IoT-Systems-Lab/Smart-Bike/Gateway/Gateway/IAQ.png

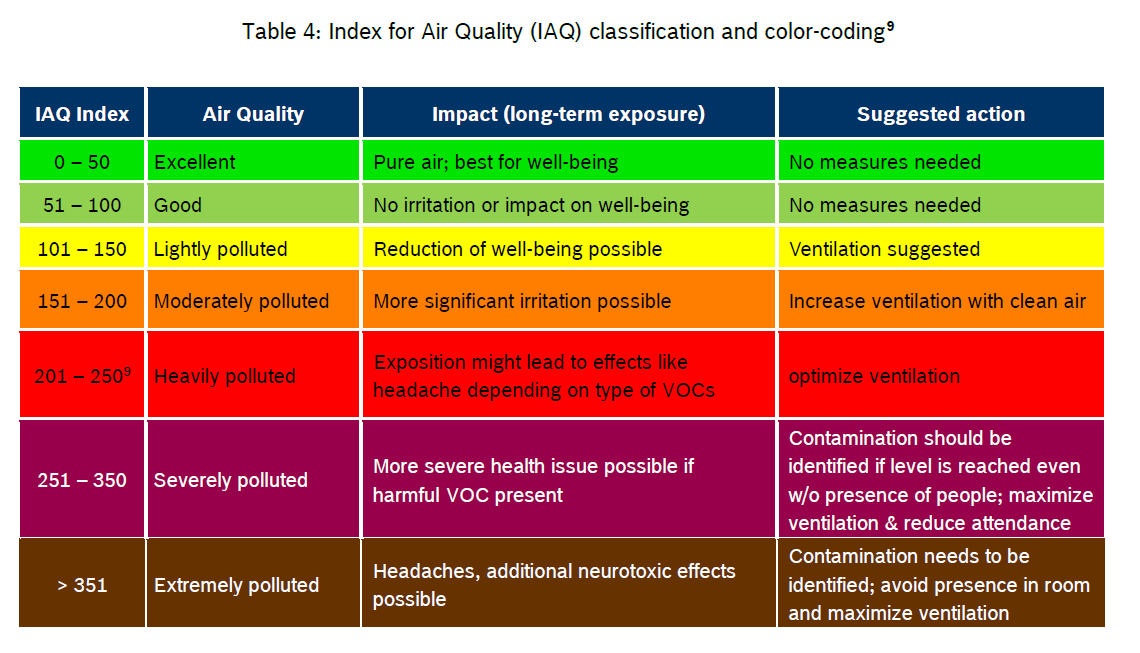
Gateway/Gateway/IAQ.png
