IoT-Systems-Lab/Smart-Bike/BOM/BOM_Mouser.xlsx

Sheet: aanvraag
AANVRAAG TOT BESTELLING < 8.500€ excl BTW
KREDIETINFO |  | BESTEL/LEVERINGSINFO
krediettype* |  | naam aanvrager |  |  | Geef dit door aan het antennelid
 |  | U-nr aanvrager |  |  | enof meldt dit hier reeds bondig.
kredietnummer |  | bestelling door? |  |  | bv specifieke leverinfo
BEDRIJFSINFO |  | bestelemail van het bedrijf
bedrijfsnaam | Mouser | VGM : O**
BTW-nr |  | WERKWIJZE ARTIKELS
straat + nr |  | Op het tweede tabblad staat een hele reeks kostensoorten. Diegene die niet van toepassing zijn op de KULLOC Gent zijn
postcode + plaats |  | reeds verwijderd. Via kolom B kan u de hele reeks filteren. Deze filter kunt u nog verfijnen via de filter in kolom C.
buitenland |  | Finaal kopieert u de juiste rubriek uit kolom A en plakt u deze in onderstaande rubriekkolom.
ARTIKELGEGEVENS |  |  |  |  |  | excl BTW
rubriek | gedetailleerde omschrijving [voor chemicaliën(gevaarlijk of schadelijk) : art.nr + CAS nr] |  |  |  | aantal | p/e | subtotaal
50654 | ESP32-C3 microcontroller [356-ESP32C3WROM02UN4] |  |  |  | 3 | 3.42 | 10.26
50654 | Ambient Light Sensors LOW PWR,HI SENS AMBIENT SENSOR [VEML6035] |  |  |  | 1 | 1.01 | 1.01
50654 | 2.4GHz omnidirectionele antenne [909-ENNAWIFIBTUFL] |  |  |  | 2 | 0.98 | 1.96
50654 | MOSFETs Transistor, MOSFET Nch, 20V(Vdss), 3.0A(Id), (2.5V Drive) [0755-RA1C030LDT5CL] |  |  |  | 3 | 0.42 | 1.26
50654 | BOSCH BME680 sensor [262-BME680] |  |  |  | 1 | 7.44 | 7.44
50654 | GNSS/GPS Modules Teseo ROM GNSS module [TESEO-LIV3R] |  |  |  | 1 | 9.58 | 9.58
50654 | Bluetooth Modules - 802.15.1 BGM260P Module 2.4G Built in Antenna Vault High 20dBm 3200kB 512kB(RAM) 26GPIO [634-BGM260PB32VNA2] |  |  |  | 1 | 9.66 | 9.66
50654 | IMUs - Inertial Measurement Units World's Lowest Power 9-Axis MEMS MotionTracking Device [ICM-20948] |  |  |  | 2 | 5.83 | 11.66
50654 | Board Mount Hall Effect/Magnetic Sensors 3-wire uPower Unipolar Direct South Switch Ts=100ms PP Bop/Brp 3.6/2.1mT [MLX92216ELQ-AAC-001-RE] |  |  |  | 5 | 0.34 | 1.72
50654 | USB-C connector [640-USB4215-03-A] |  |  |  | 5 | 0.52 | 2.60
50654 | Mini button [640-SWT0010015016SSA] |  |  |  | 10 | 0.45 | 4.45
50654 | Headers & Wire Housings PHD HEADER (SIDE) [S10B-PHDSS(LF)(SN)(P)] |  |  |  | 2 | 0.33 | 0.65
50654 | Power Switch ICs - Power Distribution 0.73-? 5-V ultra-l ow leakage load switch [TPS22860DBVR] |  |  |  | 1 | 0.89 | 0.89
50654 | Power Switch ICs - Power Distribution Low Input Voltage Du al Load Switch [TPS22960DCNR] |  |  |  | 1 | 0.77 | 0.77
50654 | Antennas Embedded Antenna, FPC + Cable, Adhesive mount, 39.45 13.25mm, Passive, GNSS L1*1,100mm, RF1.13, RF1, RoHS&REACH Compliant [YFGA003AA] |  |  |  | 1 | 1.64 | 1.64
50654 | Schottky Diodes & Rectifiers Diode Schottky 25V 1A 2-Pin [RB161MM-20TR] |  |  |  | 10 | 0.26 | 2.55
50654 | Signal Conditioning - 40 C to + 85 C 1.5824 GHz 1 dB 2 MHz, 4.092 MHz, 8.34 MHz 50 Ohms GNSS [B39162B4327P810] |  |  |  | 1 | 1.28 | 1.28
50654 | LDO Voltage Regulators AC 200mA Low IQ LDO Reg [TLV70018QDDCRQ1] |  |  |  | 1 | 0.78 | 0.78
50654 | Power Switch ICs - Power Distribution 5.5-V 2-A 80-mohm 10-nA leakage load A 595-TPS22917DBVT [TPS22917DBVR] |  |  |  | 1 | 0.40 | 0.40
50654 | RF Amplifier RF SILICON MMIC [BGA725L6E6327FTSA1] |  |  |  | 5 | 0.32 | 1.59
50654 | RF Connectors / Coaxial Connectors SMT MALE RECEPT AU [U.FL-R-SMT-1(60)] |  |  |  | 1 | 0.97 | 0.97
50654 | Headers & Wire Housings 20P SINGLE ROW [2-826646-0] |  |  |  | 1 | 1.89 | 1.89
50654 | Headers & Wire Housings 2.54mm DRSW Hdr TH /OCap .38AuLF 2Ckt [87914-0204] |  |  |  | 1 | 0.16 | 0.16
50654 | Non-Isolated DC/DC Converters 3-17Vin 3.3Vout 1A [RPM3.3-1.0-CT] |  |  |  | 1 | 5.24 | 5.24
50654 | Translation - Voltage Levels 2B Bidir Vltg-Level Translator A 595-TXB0102DCUT [TXB0102DCUR] |  |  |  | 1 | 0.58 | 0.58
50654 | Translation - Voltage Levels 8B Bidir Vltg-Level Translator [TXB0108DQSR] |  |  |  | 1 | 1.31 | 1.31
50654 | Single Colour LEDs WL-SMTW 1608 Wtrclr TopVw Blue 3.1V 100mA 470nm |  |  |  | 2 | 0.19 | 0.38
50654 | Single Colour LEDs WL-SMTW 1608 Wtrclr TopVw Green 3.3V 100mA 515nm |  |  |  | 2 | 0.19 | 0.38
50654 | Ferrite Beads 600 OHM 1A 2 PADS [MFBA2V1608-601-R] |  |  |  | 10 | 0.04 | 0.37
50654 |  |  |  |  |  |  | 0.00
50654 |  |  |  |  |  |  | 0.00
50654 |  |  |  |  |  |  | 0.00
50654 |  |  |  |  |  |  | 0.00
50654 |  |  |  |  |  |  | 0.00
50654 |  |  |  |  |  |  | 0.00
50654 |  |  |  |  |  |  | 0.00
50654 |  |  |  |  |  |  | 0.00
50654 |  |  |  |  |  |  | 0.00
50654 |  |  |  |  |  |  | 0.00
 |  |  |  |  |  |  | 0.00
 |  |  |  |  |  |  | 0.00
Voeg gerust lijnen toe, maar zorg ervoor dat de som blijft kloppen. |  |  |  |  | 77 |  | €83.43
BEZORG MIJ VIA MAIL AAN MIJN KREDIETBEHEERDER MET ALS ONDERWERP : [ BB ] |  |  | BTW recuperatie?
* meerdere kredieten kunnen gecombineerd worden, maar geen KULC (ZKC../V…) met LRD (ZLK…) kredieten combineren |  |  | KUL C : | neen | Uw budget zal verminderen
** O kolom moet enkel aangekruist worden voor schadelijke en/of gevaarlijke producten (de meeste chemische producten). |  |  | met het bedrag incl BTW of mbt deze bestelbon : |  |  |  | €100.95
Hiervoor moet om VGM redenen ook goederenontvangst gedaan worden. Wanneer dergelijke goederen geleverd worden, |  |  | LRD : | ja | Het BTW-bedrag gaat niet van uw budget.
moet dit direct aan de financiële antenne gemeld worden (ev. levernota's bezorgen). |  |  | Dank u wel om mij volledig in te vullen

Sheet: kostensoort
 | FILTERS
Rubriek | Thema | Goed/dienst | Artikelomschrijving | Grootboekrek. | Grootboekrekeningomschrijving | Gebruik | Voorbeelden | Advies aankoopbeleid
50493 | klein onderhoud | informatica | Kl.onderhoud&herstel - hardware/netwerk | 61101010 | KLEIN ONDERH.&HERSTELL. - UITRUSTING | nazicht keuring reparaties
50492 | klein onderhoud | mach/appar & uitr | Kl.onderhoud&herstel - mach/appar & uitr | 61101010 | KLEIN ONDERH.&HERSTELL. - UITRUSTING | nazicht keuring reparaties | *) herstelling *) onderhoud & keuring toestellen *) ijken & kalibreren van apparatuur labo of elders
50495 | klein onderhoud | meubilair | Kl.onderhoud&herstel - meubilair | 61111010 | KLEIN ONDERH.&HERST - MEUBILAIR | nazicht keuring reparaties | *) reparaties meubelen *) behandeling meubilair met beschermend product
50498 | klein onderhoud | rollend materieel | Kl.onderhoud&herstel - rollend materieel | 61131010 | KLEIN ONDERH. & HERSTELL. - ROLLEND MATERIEEL | nazicht keuring reparaties | *) technische keuring voertuigen *) herstelling & onderhoud voertuigen
50501 | klein onderhoud | kunst | Kl.onderhoud&herstel - kunstwerken | 61151010 | KLEIN ONDERH. & HERSTELL. - KUNSTWERKEN | nazicht keuring reparaties | *) restauratie
50503 | klein onderhoud | boeken | Kl.onderhoud&herstel - bibliotheekboeken | 61161010 | KLEIN ONDERH. & HERSTELL. - BOEKEN BIBLIOTHEKEN |  | *) inbinden *) restauratie
50844 | huur & leasing | mach/appar & uitr | Huur & leasing machines met ak.optie | 60633000 | LEASING UITRUSTING | Voor alle machines, toestellen, apparaten, uitrusting,… | *) wetenschappelijke apparatuur *) podium *) attracties personeelsfeest | leasing met aankoopoptie verloopt via aankoop
50845 | huur & leasing | meubilair | Huur & leasing meubilair met Ak.optie | 60634000 | LEASING MEUBILAIR & ROLLEND MATERIEEL
50486 | huur & leasing | gebouwen | Huur & leasing terreinen & gebouwen | 61000010 | HUUR TERREINEN EN GEBOUWEN |  | * ) gronden, parkings, lokalen, appartement,… *) huur gîte voor teambuilding *) huurgelden kamer/studio/appt betaald door K.U.Leuven voor studenten, gastprofessoren,…
50491 | huur & leasing | mach/appar & uitr | Huur & leasing machines zonder ak.optie | 61100010 | HUUR UITRUSTING | Voor alle machines, toestellen, apparaten, uitrusting,… | *) huur kopieermachine & alle bijkomende kosten ° onderhoud ° vergoeding extra kopieën ° installatiekosten *) wetenschappelijke apparatuur *) podium *) kostuums (bvb Sinterklaas/kerstfeest) *) attracties personeelsfeest *) huur sportmateriaal *) huur EHBO hulppost bij activiteiten *) staangeld gasflessen *) huur gastank
50494 | huur & leasing | meubilair | Huur & leasing meubilair zonder Ak.optie | 61110010 | HUUR MEUBILAIR
50496 | huur & leasing | rollend materieel | Huur & leasing bedrijfswagens | 61120010 | HUUR ROLLEND MATERIEEL - BEDRIJFSWAGENS |  |  | enkel occasionele huur (bepaalde periode) anders via aankoop
50497 | huur & leasing | andere | Huur & leasing andere dan bedrijfswagens | 61130010 | HUUR ROLLEND MATERIEEL - ANDERE DAN BEDRIJFSWAGENS |  | *) huur bestelwagen *) huur aanhangwagen | enkel occasionele huur (bepaalde periode) anders via aankoop
50499 | huur & leasing | informatica | Huur databanken | 61140010 | HUUR INFORMATICA: SOFTWARE & LICENTIES |  | *) huur van gegevens op CD-ROM *) toegang tot gegevens op internet
50680 | huur & leasing | informatica | Huur informatica, software & licenties | 61140010 | HUUR INFORMATICA: SOFTWARE & LICENTIES |  | enkel bij periodiek hernieuwbare software, jaarlijkse huur webruimte, gebruik van paketten, versies => aankoop software via art 50658 of 50687
50500 | huur & leasing | kunst | Huur kunstwerken | 61150010 | HUUR KUNSTWERKEN
50502 | huur & leasing | boeken | Huur boeken | 61160010 | HUUR BOEKEN BIBLIOTHEKEN
50684 | goed | informatica | Computer-hardware < 250 EUR/st excl BTW | 61170010 | KLEINE UITRUSTING |  | *) externe harddisk | basisassortiment verkrijgbaar via PC shop
50657 | investering | informatica | Computer-hardware > 250 EUR/st excl BTW | 60610000 | UITRUSTING | Uitzonderlijk te gebruiken want basisassortiment verkrijgbaar via PC shop (printer, desktop, notebook, beeldscherm,…) | *) grote server *) grote computersystemen & -projecten | advies vragen aan PC-shop
50687 | goed | informatica | Computer-software < 250 EUR/st excl BTW | 61170010 | KLEINE UITRUSTING |  |  | basisassortiment verkrijgbaar via PC shop
50658 | investering | informatica | Computer-software > 250 EUR/st excl BTW | 60630000 | SOFTWARE | Uitzonderlijk te gebruiken want basisassortiment verkrijgbaar via PC shop | *) specifieke softwaretoepassingen | advies vragen aan PC-shop of aankoop
50507 | goed | meubilair | Inrichting < 250 EUR/st excl BTW | 61170010 | KLEINE UITRUSTING |  | *) gordijnen *) spiegel *) signalisatiebordjes
50839 | investering | meubilair | Inrichting > 250 EUR/st excl BTW | 60620000 | MEUBILAIR
50506 | uitzonderlijk | meubilair | Meubilair < 250 EUR/st excl BTW | 61170010 | KLEINE UITRUSTING |  | *) kapstok
50836 | uitzonderlijk | meubilair | Meubilair > 250 EUR/st excl BTW | 60620000 | MEUBILAIR |  | *) zetel voor wachtruimte *) ergonomisch/aangepast meubilair *) borden, tafels, stoelen, kasten | raamcontract gebruiken voor standaard meubilair - bij afwijkingen advies aan aankoop vragen
50505 | goed | meubilair | Uitrusting&machines < 250EUR/st excl btw | 61170010 | KLEINE UITRUSTING | Voor alle machines, toestellen, apparaten, uitrusting,… | *) bureaulamp *) koffiezet *) tafelwagen voor labo
50510 | uitzonderlijk | andere | Communicatie - Toestellen | 61170010 | KLEINE UITRUSTING |  | *) dictafoon *) antwoordapparaat *) webcam | *) voor GSM's contacteer aankoop *) voor faxtoestellen: raamcontract *) voor vaste telefoontoestellen : contacteer centrale dispatch
50814 | goed | mach/appar & uitr | Uitrusting&machines > 250EUR/st excl BTW | 60610000 | UITRUSTING | Voor alle machines, toestellen, apparaten, uitrusting,… | *) microscoop *) LCD projector *) TV toestel *) brandblusser *) brander *) autoclaaf *) waterpompen
50488 | uitzonderlijk | andere | Bewaking door derden | 61004000 | BEWAKING DOOR DERDEN |  |  | raamcontract TD - contacteer de dienst beveiliging & schoonmaakbeleid
50489 | uitzonderlijk | andere | Schoonmaak door derden | 61005000 | SCHOONMAAK DOOR DERDEN |  |  | raamcontract TD - contacteer de dienst beveiliging & schoonmaakbeleid
50490 | uitzonderlijk | andere | Verhuiskosten | 61006000 | VERHUISKOSTEN | Voor alle kosten m.b.t. verhuizing (huur dozen, werkuren personeel,…) |  | Bij voorkeur per e-mail aanvragen bij de centrale dispatch
50512 | dienst | labo | Leveringen - gas | 61201002 | LEVERINGEN - GAS |  |  | raamcontract TD
50517 | uitzonderlijk | andere | Linnen & kledij: aankoop | 61201006 | LEVERINGEN - LINNEN & KLEDIJ: AANKOOP & ONDERHOUD |  | *) vlag *) sportkledij *) badmutsen *) handschoenen labo *) stoffen rollen / handdoeken | Voor de meeste werkkledij bestaat er een raamcontract: contacteer de dienst schoonmaakbeleid
50516 | klein onderhoud | andere | Linnen & kledij: onderhoud & herstelling | 61201006 | LEVERINGEN - LINNEN & KLEDIJ: AANKOOP & ONDERHOUD
50518 | uitzonderlijk | andere | Persoonlijke beschermingsmiddelen | 61201006 | LEVERINGEN - LINNEN & KLEDIJ: AANKOOP & ONDERHOUD | uitsluitend voor specifieke persoonlijke beschermingsmiddelen | *) laserbrillen *) glasblazerbrillen *) bescherming kettingzagen | aanvraagformulier PBM voor standaard persoonlijke beschermingsmiddelen (veiligheidsbrillen, maskers, hittebestendige handschoenen, gehoorbescherming, veiligheidsschoenen, …)
50654 | goed | labo | Materiaal atelier / werkplaats | 61201008 | LEVERINGEN - ONDERZOEKSMATERIAAL & PRODUCTEN LABO |  | * )metalen *) hout *) schroeven *) handgereedschap *) elektr. componenten/gereedsch./materiaal | heel veel items zijn voorradig in de magazijnen
50520 | goed | labo | Materiaal labo - géén uitrust of product | 61201008 | LEVERINGEN - ONDERZOEKSMATERIAAL & PRODUCTEN LABO |  | *) naalden *) glaswerk *) disposables *) elektronische, mechanische en elektrische componenten buiten CDE *) staangeld gasflessen
50652 | goed | labo | Laboproducten (zonder R-zin of vergunn) | 61201008 | LEVERINGEN - ONDERZOEKSMATERIAAL & PRODUCTEN LABO | uitsluitend voor niet gevaarlijke producten | *) gedistilleerd water *) stikstof *) micro-organismen *) biochemische producten zonder R-zin of vergunning | rechtstreeks in SAP of via CASP - producten met gevaren-zin of externe vergunning moeten in SAP besteld worden via tabblad "chemische materialen"
42457 | uitzonderlijk | andere | Leveringen - liturgie | 61201009 | LEVERINGEN - LITURGIE
46497 | uitzonderlijk | informatica | Levering informaticadiensten | 61201010 | LEVERING INFORMATICADIENSTEN |  | *) software upgrade *) onderhoud *) technische bijstand *) creatie website *) …
50870 | uitzonderlijk | werking | Kosten m.b.t. landbouwproducten | 61210001 | KOSTEN M.B.T. LANDBOUWPRODUCTEN
50664 | uitzonderlijk | derden | Prijzengeld betaald aan derden | 61300300 | PRIJZENGELD BETAALD AAN DERDEN |  | *) prijs toegekend aan een student
50665 | uitzonderlijk | derden | Auteursrechten (géén SABAM of REPROBEL) | 61300400 | AUTEURSRECHTEN | Bij betaling aan een privé persoon (geen centrale instantie, zie art. 50908)
50668 | uitzonderlijk | derden | Vergoeding stagementoren | 61300800 | VERGOEDING STAGEMENTOREN
50669 | uitzonderlijk | derden | Erelonen advocaten | 61310100 | ERELONEN ADVOCATEN
50670 | uitzonderlijk | derden | Erelonen octrooi / patentbureau's | 61310200 | ERELONEN OCTROOI / PATENTBUREAU'S
50673 | uitzonderlijk | derden | Kosten analyses laboratoria | 61310300 | ERELONEN LABORATORIA |  | *) uitbesteding wetenschappelijk experiment
50675 | dienst | derden | Erelonen adviesbureau - productiefirma's - externe sprekers | 61310400 | ERELONEN ADVIESBUREAUS-PRODUCTIEFIRMAS-CONSULTANTS |  | *) aankoop van data (vb meteorologisch instituut) *) aankoop van (markt)onderzoeken, rapporten *) externe sprekers *) keuringen *) analyses *) …
50677 | dienst | derden | Erelonen Consultants & Audit | 61310400 | ERELONEN ADVIESBUREAUS-PRODUCTIEFIRMAS-CONSULTANTS |  | *) vergoeding externe docent
50676 | uitzonderlijk | derden | Kosten vertalers, gidsen, artiesten,... | 61310400 | ERELONEN ADVIESBUREAUS-PRODUCTIEFIRMAS-CONSULTANTS |  | *) rondleiding museum *) scheidsrechters | raamcontract voor vertalingen
50690 | uitzonderlijk | informatica | Computer-verbruiksartikelen < 250EUR/st | 61312000 | KANTOORBENODIGDHEDEN
50679 | uitzonderlijk | kantoor | Kantoorartikelen < 250 EUR/ST excl.BTW | 61312000 | KANTOORBENODIGDHEDEN | heel uitzonderlijk |  | meeste zaken te verkrijgen via raamcontract of de magazijnen
51016 | uitzonderlijk | andere | Onderhoud & verzorging planten in burelen | 61312000 | KANTOORBENODIGDHEDEN
50682 | dienst | werking | Opleiding - seminaries - conferenties | 61315000 | OPLEIDING - SEMINARIES - CONFERENTIES | Voor élke opleiding-seminarie-conferentie waarvan K.U.Leuven de kosten draagt | *) inschrijvingsgeld opleiding buitenlandse student *) inschrijvingsgeld studiedag
50683 | uitzonderlijk | werking | Medische kosten | 61316000 | MEDISCHE KOSTEN |  | *) geneesmiddelen voor studenten *) geneesmiddelen, windels, plakkers voor huisapotheek of EHBO kit *) facturen controle-artsen, vaccins aan personeel,…
50686 | goed | boeken | Boeken - tijdschriften - kranten | 61320000 | BOEKEN - TIJDSCHRIFTEN - KRANTEN - LIDMAATSCH.BIJDR. |  | *) DVD met daarop een naslagwerk
50688 | dienst | boeken | Lidmaatschapsbijdragen | 61320000 | BOEKEN - TIJDSCHRIFTEN - KRANTEN - LIDMAATSCH.BIJDR. |  | *) Vlerick alumni club *) CM lidmaatschap studenten
50689 | uitzonderlijk | andere | Tussenkomst personeelsverenigingen | 61321000 | TUSSENKOMST PERSONEELSVERENIGINGEN |  | *) K.U.Leuven wandelclub
50691 | uitzonderlijk | geschenk | Geschenken aan niét-personeelsleden | 61330000 | GESCHENKEN AAN NIET-PERSONEELSLEDEN |  | *) trofeeën en medailles
50713 | uitzonderlijk | geschenk | Geschenken aan personeel (vrijgesteld) | 61331000 | GESCHENKEN AAN PERSONEEL (VRIJGESTELD) |  | *) kado-bon voor stagiair die via K.U.Leuven contract was tewerkgesteld (dus géén interim of géén externe consultant) *) afscheidskado bij pensionering
50718 | uitzonderlijk | geschenk | Giften en liberaliteiten | 61332000 | GIFTEN & LIBERALITEITEN
50716 | uitzonderlijk | geschenk | Sponsering (extern) | 61333000 | SPONSORING (EXTERN) |  | *) kindervoetbalclub
50721 | uitzonderlijk | andere | Waarborgen | 61360000 | WAARBORGEN |  | *) waarborg
50724 | uitzonderlijk | andere | Communicatie - gesprekskosten | 61370000 | TELEFOON, GSM & FAX |  |  | GSM via aankoopdienst - vaste telefonie via TD
50726 | uitzonderlijk | andere | Internet & TV | 61371000 | INTERNET & TV | voor alle types internetaansluiting en tv |  | *) voor internet: contact opnemen met aankoop *) voor kabeltelevisie: contact opnemen met TD
50730 | goed | kantoor | Verzendings- & frankeerkosten post | 61372000 | VERZENDINGS- & FRANKEERKOSTEN POST |  | *) postzegels *) postpakjes | contacteer de centrale logistieke diensten
50735 | goed | drukwerk | Fotokopies | 61380000 | DRUKWERK & ADVERTENTIES |  | *) reproducties bv. foto, scan, kleurendia, microfilm… *) fotokopiekaart: kaart waar geld op staat en waar men dan fotokopieën kan nemen
50733 | dienst | drukwerk | Drukwerk - publicaties | 61380000 | DRUKWERK & ADVERTENTIES | Alle drukwerk dat we bij drukkerij kunnen aankopen | *) enveloppen met label K.U.Leuven *) naamkaartjes | contacteer de cel marketingadvies binnen de dienst communicatie voor advies ivm drukwerk, publicaties, publiciteit en advertenties (http://www.kuleuven.be/communicatie/raamcontract.html)
50739 | dienst | drukwerk | Publiciteit & advertenties | 61380000 | DRUKWERK & ADVERTENTIES |  |  | contacteer de cel marketingadvies binnen de dienst communicatie voor advies ivm drukwerk, publicaties, publiciteit en advertenties (http://www.kuleuven.be/communicatie/raamcontract.html)
50917 | dienst | catering | Catering zonder bediening | 61381000 | CATERING & RESTAURANT |  | *) cantus studenten
50745 | dienst | catering | Restaurant & catering met bediening | 61381000 | CATERING & RESTAURANT |  | *) lunch/diner in Faculty Club
50748 | goed | catering | kantinebenodigdheden personeel | 61382000 | KANTINEBENODIGDHEDEN PERSONEELSREFTER | Geen materiaal of uitrusting | *) frisdranken *) koffie *) suiker | raamcontract bij Alma
50760 | dienst | werking | Beurzen - tentoonstellingen | 61383000 | BEURZEN - TENTOONSTELLINGEN |  | *) inkomgeld tentoonstelling *) kosten mbt organisatie beurs (incl. adsl, electriciteit …)
51149 | uitzonderlijk | werking | Culturele activiteit | 61383000 | BEURZEN - TENTOONSTELLINGEN |  | *) museumbezoek *) film *) uitstap personeel *)
50767 | dienst | werking | Verblijf- & verplaatsingskosten | 61500000 | VERBLIJF- & VERPLAATSINGSKOSTEN | énkel het verblijf en de verplaatsing, niet: eten & drinken (=> catering) | *) hotel, appartement bij verplaatsing in dienstverband *) trein, taxi, bus, vliegtuig *) busreizen studenten *) kosten verblijfsvergunning
50768 | dienst | andere | Transportkosten goederen | 61520000 | TRANSPORTKOSTEN GOEDEREN |  |  | contacteer de centrale logistieke diensten
50770 | uitzonderlijk | andere | Afval transport & - verwerking | 61530000 | AFVALTRANSPORT & -VERWERKING
50772 | uitzonderlijk | andere | Interims (uitzendkrachten) | 61700000 | UITZENDKRACHTEN | enkel via erkend uitzendbureau | *) Adecco *) Randstad
51086 | uitzonderlijk | andere | Invoerrechten, douane, accijnzen | 64014000 | DOUANE & ACCIJNZEN | enkel voor invoerrechten, douane of accijnzen die vooraf gekend zijn en besteld kunnen worden
52415 | uitzonderlijk | andere | Administratieve kost | 61313500 | ADMINISTRATIEVE KOST | enkel voor een administratieve kost die geen deel uitmaakt of hoort bij de hoofdzaak op een document, maar dus volledig op zichzelf staat | *) vaste kost voor het verkrijgen van documenten van de gemeente *) …
