IoT-Systems-Lab/Smart-Bike/Gateway/PCB/Schematic_gateway.pdf

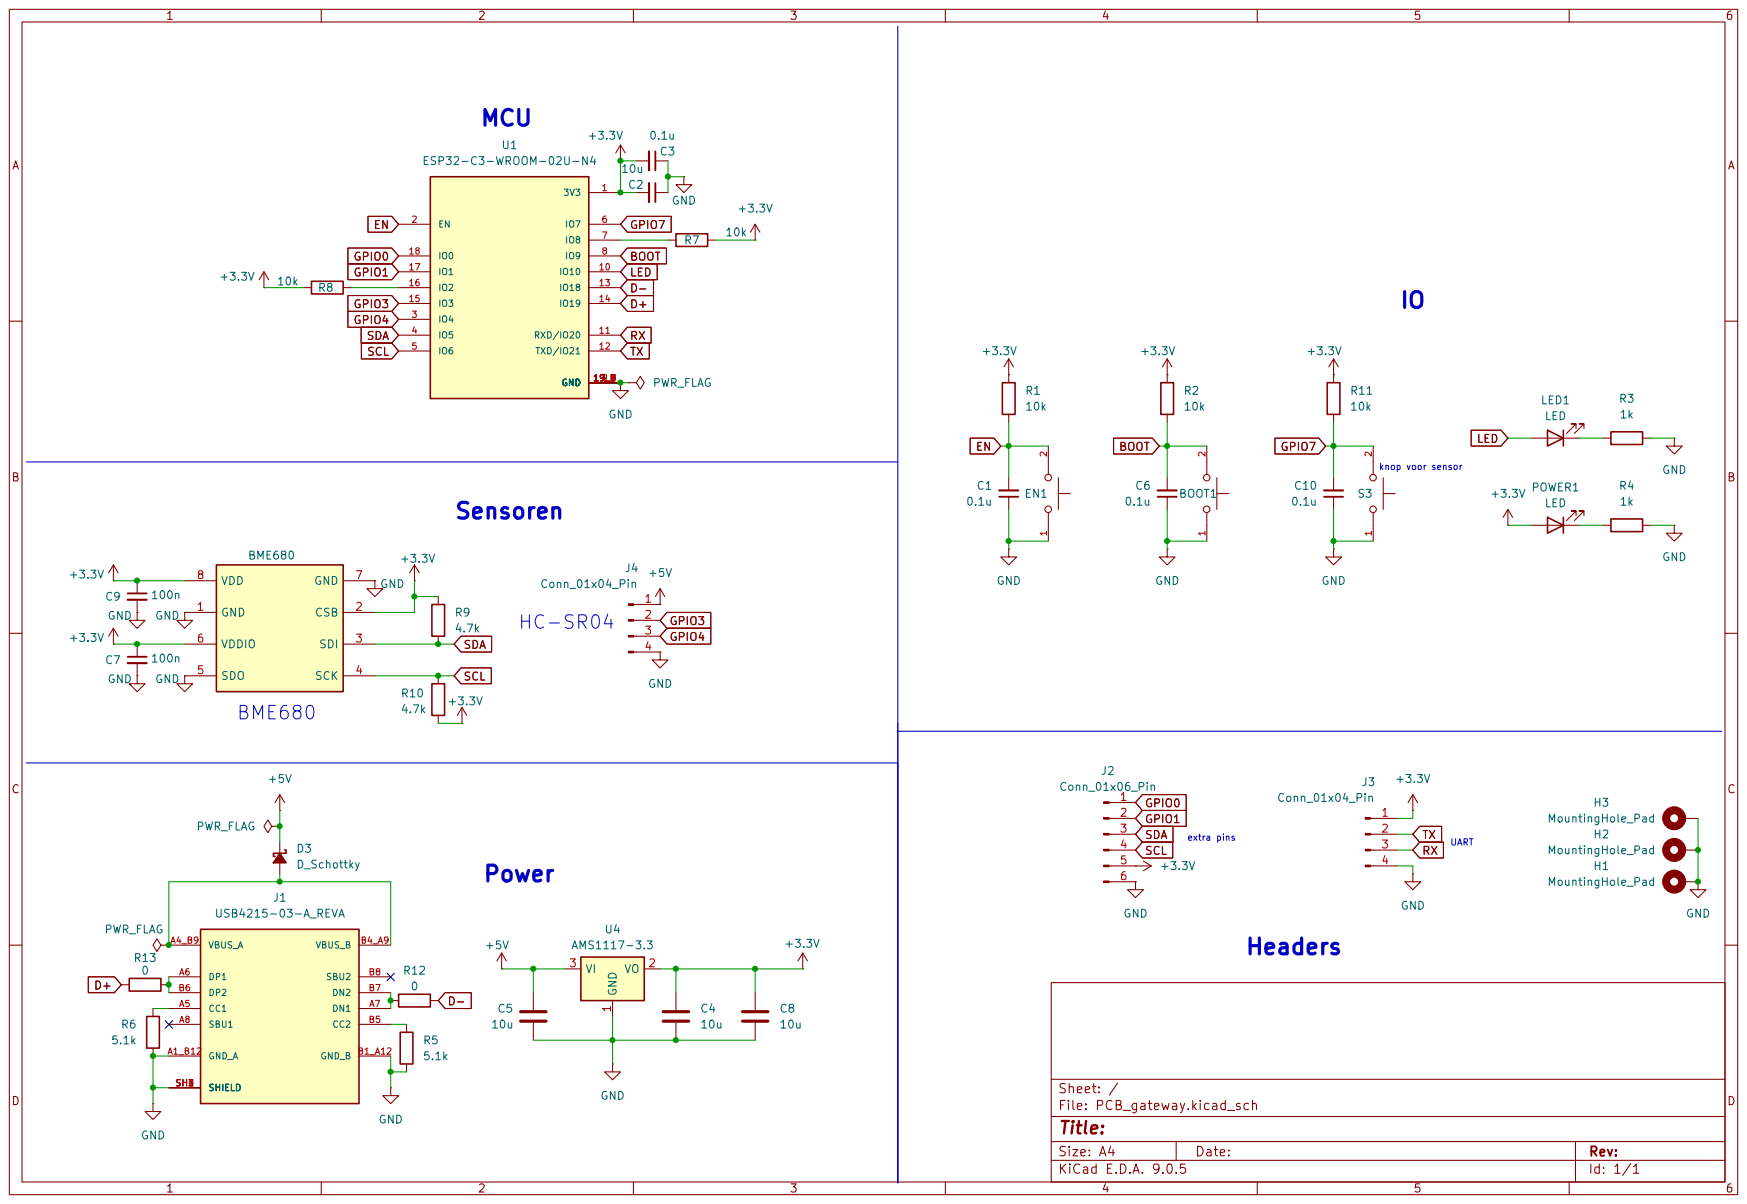
[picture p3: page 1]
