IoT-Systems-Lab/Smart-Bike/(list of files, drawings)

Other design files:
Sensors/Voorvork/PCB1.PcbDoc
Sensors/Voorvork/SmartBike.PrjPcb
Sensors/Voorvork/Voorvork.SchDoc
