IoT-Systems-Lab/Smart-Bike/Sensors/Main/Main_Bike_Print.kicad_pcb

## KiCad design Sensors/Main/Main_Bike_Print.kicad_pcb (2025-10-20)

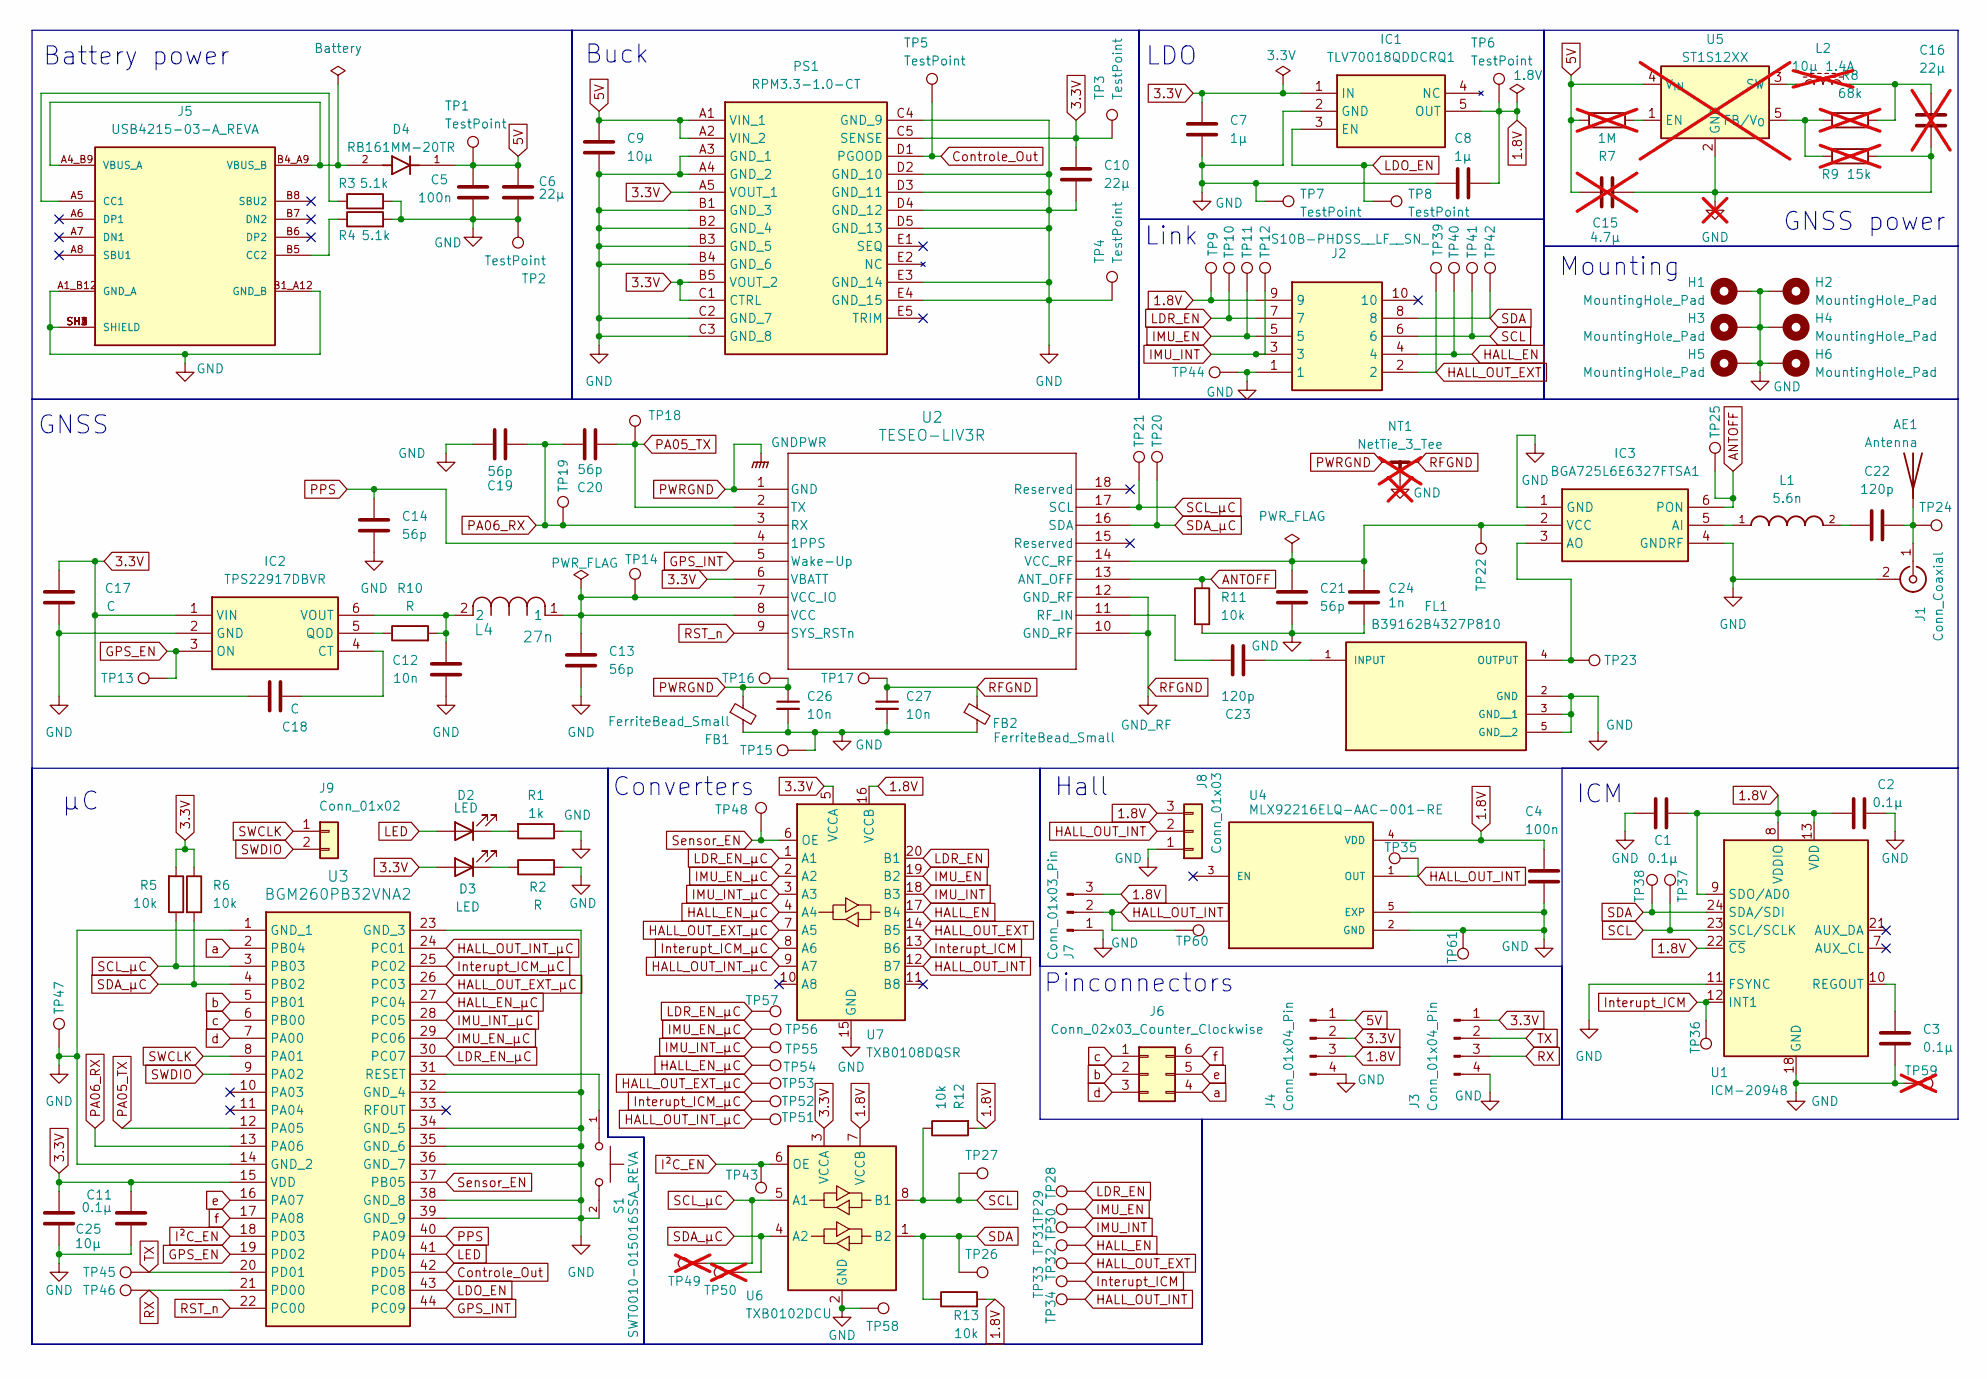
[picture p4: schematic Main_Bike_Print.kicad_sch, IoT-Bike_central_console]

Parts:
AE1: Antenna
C1, C2, C3, C11: 0.1µ; C_0603_1608Metric_Pad1.08x0.95mm_HandSolder
C4, C5: 100n; C_0603_1608Metric_Pad1.08x0.95mm_HandSolder
C6, C10: 22µ; C_0603_1608Metric_Pad1.08x0.95mm_HandSolder
C7, C8: 1µ; C_0603_1608Metric_Pad1.08x0.95mm_HandSolder
C9, C25: 10µ; C_0603_1608Metric_Pad1.08x0.95mm_HandSolder
C12, C26, C27: 10n; C_0603_1608Metric_Pad1.08x0.95mm_HandSolder
C13, C14, C19, C20, C21: 56p; C_0603_1608Metric_Pad1.08x0.95mm_HandSolder
C15: 4.7µ; not fitted
C16: 22µ; not fitted
C17, C18: C; C_0603_1608Metric_Pad1.08x0.95mm_HandSolder
C22, C23: 120p; C_0603_1608Metric_Pad1.08x0.95mm_HandSolder
C24: 1n; C_0603_1608Metric_Pad1.08x0.95mm_HandSolder
D2, D3: LED; LED_0603_1608Metric_Pad1.05x0.95mm_HandSolder
D4: RB161MM-20TR; RB161MM20TR
FB1, FB2: FerriteBead_Small; L_0603_1608Metric_Pad1.05x0.95mm_HandSolder
FL1: B39162B4327P810; FIL_B39162B4327P810; PARTREV October 25, 2019
H1, H2, H3, H4, H5, H6: MountingHole_Pad; MountingHole_3.2mm_M3_Pad_Via
IC1: TLV70018QDDCRQ1; SOT95P280X110-5N; Mouser Part Number 595-TLV70018QDDCRQ1
IC2: TPS22917DBVR; SOT95P280X145-6N; Mouser Part Number 595-TPS22917DBVR
IC3: BGA725L6E6327FTSA1; BGS12SN6E6327XTSA1; Manufacturer_Part_Number BGA725L6E6327FTSA1
J1: Conn_Coaxial; U.FL_Hirose_U.FL-R-SMT-1_Vertical
J2: S10B-PHDSS__LF__SN_; S10BPHDSSLFSN; Manufacturer_Part_Number S10B-PHDSS (LF)(SN)
J3, J4: Conn_01x04_Pin; PinSocket_1x04_P2.54mm_Vertical
J5: USB4215-03-A_REVA; GCT_USB4215-03-A_REVA; PARTREV A
J6: Conn_02x03_Counter_Clockwise; PinHeader_2x03_P2.54mm_Vertical
J7: Conn_01x03_Pin; PinSocket_1x03_P2.54mm_Vertical
J8: Conn_01x03; JST_PH_S3B-PH-K_1x03_P2.00mm_Horizontal
J9: Conn_01x02; PinSocket_1x02_P2.54mm_Vertical
L1: 5.6n; IND_0402CS-5N6XJRW; PARTREV 08/06/21
L2: 10µ 1.4A; not fitted
L4: 27n; IND_LQG15HNR10J02_MUR
NT1: NetTie_3_Tee; NetTie-3_SMD_Pad2.0mm; not fitted
PS1: RPM3.3-1.0-CT; RPM3310CT; Manufacturer_Part_Number RPM3.3-1.0-CT
R1: 1k; R_0603_1608Metric_Pad0.98x0.95mm_HandSolder
R2, R10: R; R_0603_1608Metric_Pad0.98x0.95mm_HandSolder
R3, R4: 5.1k; R_0603_1608Metric_Pad0.98x0.95mm_HandSolder
R5, R6, R11, R12, R13: 10k; R_0603_1608Metric_Pad0.98x0.95mm_HandSolder
R7: 1M; not fitted
R8: 68k; not fitted
R9: 15k; not fitted
S1: SWT0010-015016SSA_REVA; SW_SWT0010-015016SSA_REVA; PARTREV A
TP1, TP2, TP3, TP4, TP5, TP6, TP7, TP8, TP9, TP10, TP11, TP12, TP13, TP14, TP15, TP16, TP17, TP18, TP19, TP20, TP21, TP22, TP23, TP24, TP25, TP26, TP27, TP28, TP29, TP30, TP31, TP32, TP33, TP34, TP35, TP36, TP37, TP38, TP39, TP40, TP41, TP42, TP43, TP44, TP45, TP46, TP47, TP48, TP51, TP52, TP53, TP54, TP55, TP56, TP57, TP58, TP60, TP61: TestPoint; TestPoint_Pad_D1.0mm
TP49, TP50, TP59: TestPoint; TestPoint_Pad_D1.0mm; not fitted
U1: ICM-20948; InvenSense_QFN-24_3x3mm_P0.4mm
U2: TESEO-LIV3R; ARRAY_LIV3R_STM
U3: BGM260PB32VNA2; Manufacturer_Part_Number BGM260PB32VNA2
U4: MLX92216ELQ-AAC-001-RE; SON65P120X160X40-5N; PARTREV 1.0
U5: ST1S12XX; TSOT-23-5; not fitted
U6: TXB0102DCU; VSSOP-8_2.3x2mm_P0.5mm
U7: TXB0108DQSR; USON-20_2x4mm_P0.4mm

Connections:
1.8V: C1.2, C2.1, C4.1, C8.1, IC1.5 (OUT), J2.9, J4.3, J7.3, J8.3, R12.2, R13.2, TP6.1, TP9.1, U1.8 (VDDIO), U1.9 (SDO/AD0), U1.13 (VDD), U1.22 (~CS), U4.4 (VDD), U6.7 (VCCB), U7.16 (VCCB)
3.3V: C7.1, C10.1, C11.2, C17.1, C18.1, C25.2, D3.2 (A), IC1.1 (IN), IC2.1 (VIN), J3.1, J4.2, PS1.A5 (VOUT_1), PS1.B5 (VOUT_2), PS1.C1 (CTRL), PS1.C5 (SENSE), R5.2, R6.1, TP3.1, U2.6 (VBATT), U3.15 (VDD), U6.3 (VCCA), U7.5 (VCCA)
5V: C5.1, C6.1, C9.1, C15.1, D4.1, J4.1, PS1.A1 (VIN_1), PS1.A2 (VIN_2), R7.1, TP1.1, U5.4 (V_{IN})
ANTOFF: IC3.6 (PON), R11.1, TP25.1, U2.13 (ANT_OFF)
Controle_Out: PS1.D1 (PGOOD), TP5.1, U3.42 (PD05)
GND: C1.1, C2.2, C3.2, C4.2, C5.2, C6.2, C7.2, C8.2, C9.2, C10.2, C11.1, C12.2, C13.2, C14.2, C15.2, C16.2, C17.2, C19.2, C21.2, C24.2, C25.1, C26.2, C27.2, FB1.2, FB2.2, FL1.2 (GND), FL1.3 (GND__1), FL1.5 (GND__2), H1.1, H2.1, H3.1, H4.1, H5.1, H6.1, IC1.2 (GND), IC2.2 (GND), IC3.1 (GND), IC3.4 (GNDRF), J1.2 (Ext), J2.1, J3.4, J4.4, J5.A1_B12 (GND_A), J5.B1_A12 (GND_B), J5.SH1 (SHIELD), J5.SH2 (SHIELD), J5.SH3 (SHIELD), J5.SH4 (SHIELD), J7.1, J8.1, NT1.3, PS1.A3 (GND_1), PS1.A4 (GND_2), PS1.B1 (GND_3), PS1.B2 (GND_4), PS1.B3 (GND_5), PS1.B4 (GND_6), PS1.C2 (GND_7), PS1.C3 (GND_8), PS1.C4 (GND_9), PS1.D2 (GND_10), PS1.D3 (GND_11), PS1.D4 (GND_12), PS1.D5 (GND_13), PS1.E3 (GND_14), PS1.E4 (GND_15), R1.1, R2.2, R3.2, R4.2, R9.2, R11.2, S1.2, TP2.1, TP4.1, TP7.1, TP15.1, TP44.1, TP47.1, TP58.1, TP59.1, TP61.1, U1.11 (FSYNC), U1.18 (GND), U1.20 (GND), U3.1 (GND_1), U3.14 (GND_2), U3.23 (GND_3), U3.32 (GND_4), U3.34 (GND_5), U3.35 (GND_6), U3.36 (GND_7), U3.38 (GND_8), U3.39 (GND_9), U4.2 (GND), U4.5 (EXP), U5.2 (GND), U6.2 (GND), U7.15 (GND)
GPS_EN: IC2.3 (ON), TP13.1, U3.19 (PD02)
GPS_INT: U2.5 (Wake-Up), U3.44 (PC09)
HALL_EN: J2.4, TP31.1, TP40.1, U7.17 (B4)
HALL_EN_µC: TP54.1, U3.27 (PC04), U7.4 (A4)
HALL_OUT_EXT: J2.2, TP32.1, TP39.1, U7.14 (B5)
HALL_OUT_EXT_µC: TP53.1, U3.26 (PC03), U7.7 (A5)
HALL_OUT_INT: J7.2, J8.2, TP34.1, TP35.1, TP60.1, U4.1 (OUT), U7.12 (B7)
HALL_OUT_INT_µC: TP51.1, U3.24 (PC01), U7.9 (A7)
IMU_EN: J2.5, TP11.1, TP29.1, U7.19 (B2)
IMU_EN_µC: TP56.1, U3.29 (PC06), U7.2 (A2)
IMU_INT: J2.3, TP12.1, TP30.1, U7.18 (B3)
IMU_INT_µC: TP55.1, U3.28 (PC05), U7.3 (A3)
Interupt_ICM: TP33.1, TP36.1, U1.12 (INT1), U7.13 (B6)
Interupt_ICM_µC: TP52.1, U3.25 (PC02), U7.8 (A6)
I²C_EN: TP43.1, U3.18 (PD03), U6.6 (OE)
LDO_EN: IC1.3 (EN), TP8.1, U3.43 (PC08)
LDR_EN: J2.7, TP10.1, TP28.1, U7.20 (B1)
LDR_EN_µC: TP57.1, U3.30 (PC07), U7.1 (A1)
LED: D2.2 (A), U3.41 (PD04)
unnamed: AE1.1, C22.1, J1.1 (In), TP24.1
unnamed: C16.1, L2.2, R8.1
unnamed: C22.2, L1.2
unnamed: D2.1 (K), R1.2
unnamed: D3.1 (K), R2.1
unnamed: C23.1, FL1.1 (INPUT)
unnamed: FL1.4 (OUTPUT), IC3.3 (AO), TP23.1
unnamed: C18.2, IC2.4 (CT)
unnamed: IC2.5 (QOD), R10.1
unnamed: C12.1, IC2.6 (VOUT), L4.2, R10.2
unnamed: IC3.5 (AI), L1.1
unnamed: C21.1, C24.1, IC3.2 (VCC), TP22.1, U2.14 (VCC_RF)
unnamed: J5.A5 (CC1), R3.1
unnamed: J5.B5 (CC2), R4.1
unnamed: D4.2, J5.A4_B9 (VBUS_A), J5.B4_A9 (VBUS_B)
unnamed: L2.1, U5.3 (SW)
unnamed: R7.2, U5.1 (EN)
unnamed: R8.2, R9.1, U5.5 (FB/V_{O})
unnamed: C3.1, U1.10 (REGOUT)
unnamed: C23.2, U2.11 (RF_IN)
unnamed: C13.1, L4.1, TP14.1, U2.7 (VCC_IO), U2.8 (VCC)
unnamed: S1.1, U3.31 (RESET)
PA05_TX: C20.1, TP18.1, U2.2 (TX), U3.12 (PA05)
PA06_RX: C19.1, C20.2, TP19.1, U2.3 (RX), U3.13 (PA06)
PPS: C14.1, U2.4 (1PPS), U3.40 (PA09)
PWRGND: C26.1, FB1.1, NT1.1, TP16.1, U2.1 (GND)
RFGND: C27.1, FB2.1, NT1.2, TP17.1, U2.10 (GND_RF), U2.12 (GND_RF)
RST_n: U2.9 (SYS_RSTn), U3.22 (PC00)
RX: J3.3, TP46.1, U3.21 (PD00)
SCL: J2.6, R12.1, TP27.1, TP37.1, TP41.1, U1.23 (SCL/SCLK), U6.8 (B1)
SCL_µC: R5.1, TP21.1, TP49.1, U2.17 (SCL), U3.3 (PB03), U6.5 (A1)
SDA: J2.8, R13.1, TP26.1, TP38.1, TP42.1, U1.24 (SDA/SDI), U6.1 (B2)
SDA_µC: R6.2, TP20.1, TP50.1, U2.16 (SDA), U3.4 (PB02), U6.4 (A2)
SWCLK: J9.1, U3.8 (PA01)
SWDIO: J9.2, U3.9 (PA02)
Sensor_EN: TP48.1, U3.37 (PB05), U7.6 (OE)
TX: J3.2, TP45.1, U3.20 (PD01)
a: J6.4, U3.2 (PB04)
b: J6.2, U3.5 (PB01)
c: J6.1, U3.6 (PB00)
d: J6.3, U3.7 (PA00)
e: J6.5, U3.16 (PA07)
f: J6.6, U3.17 (PA08)

Notes on the sheet:
Battery power
Link
Converters
ICM
LDO
Mounting
Pinconnectors
GNSS
Buck
GNSS power
Hall

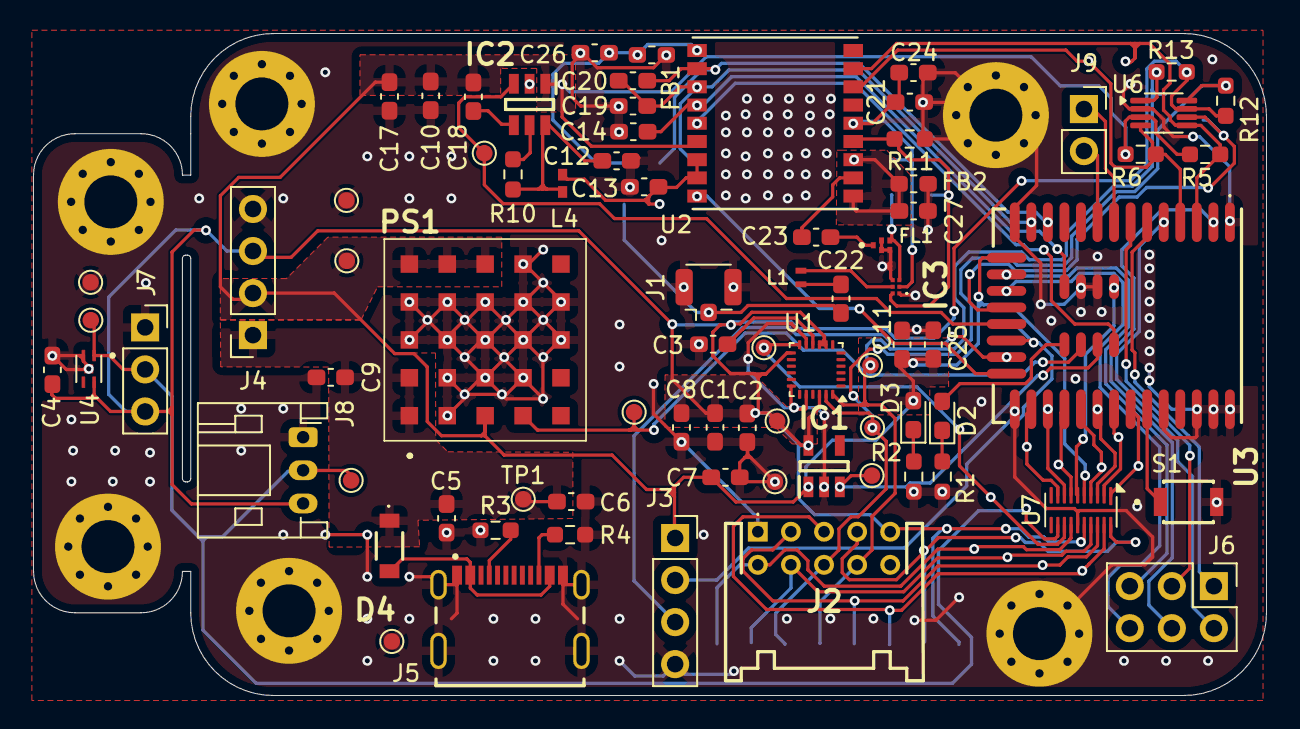
[picture p5: board Main_Bike_Print.kicad_pcb from above]

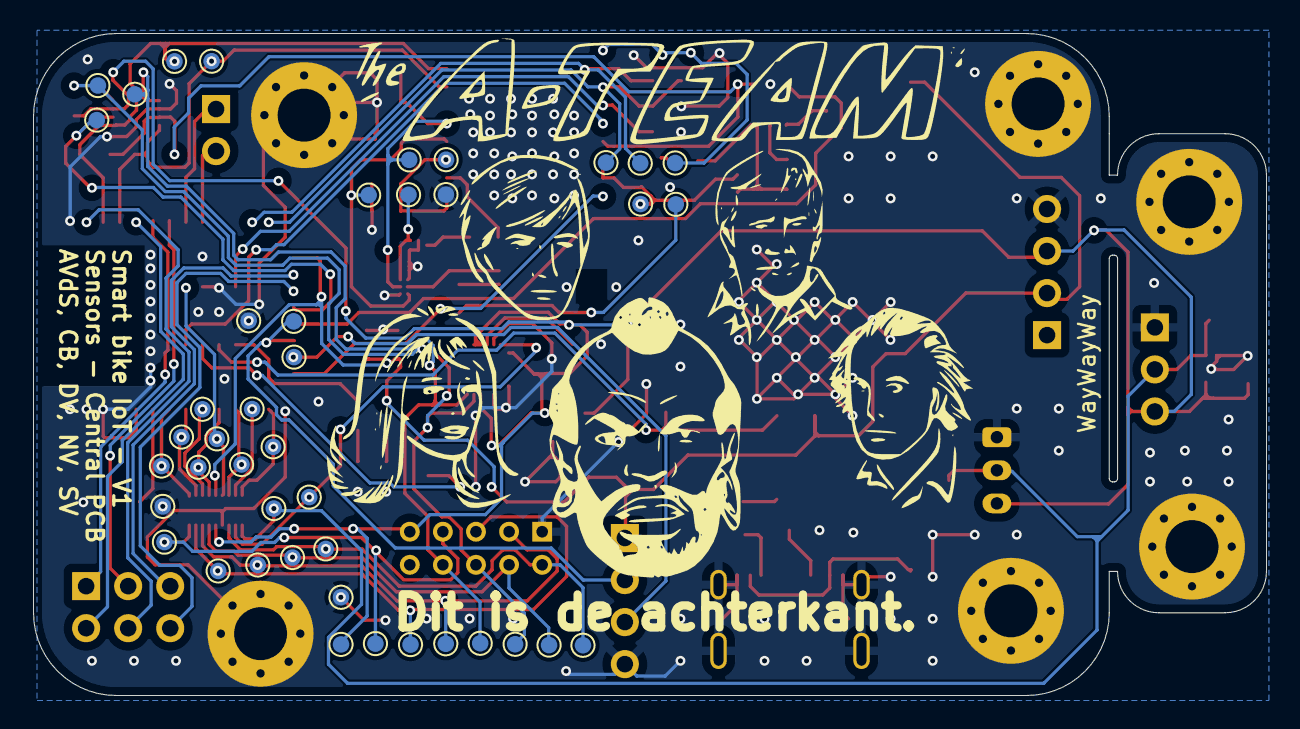
[picture p6: board Main_Bike_Print.kicad_pcb from below]

Board: 2 copper layers, 74.5 x 40.0 mm, 127 parts (43 on the bottom side), 64 nets.
