IoT-Systems-Lab/Smart-Bike/Gateway/PCB/PCB_gateway.kicad_pcb

## KiCad design Gateway/PCB/PCB_gateway.kicad_pcb (2025-10-16)

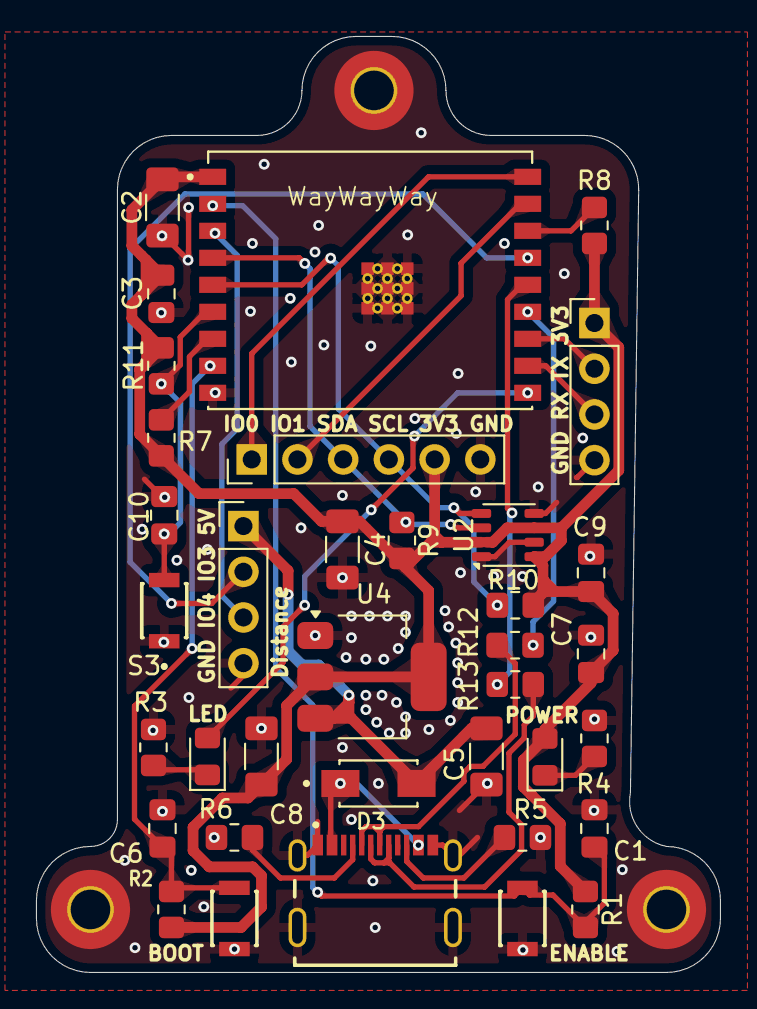
[picture p7: board PCB_gateway.kicad_pcb from above]

Board: 2 copper layers, 38.0 x 52.0 mm, 39 parts (0 on the bottom side), 26 nets.

Parts:
BOOT: SWT0010-015016SSA_REVA; SW_SWT0010-015016SSA_REVA
C1, C3, C6, C10: 0.1u; C_0805_2012Metric_Pad1.18x1.45mm_HandSolder
C2, C4, C5, C8: 10u; C_1206_3216Metric_Pad1.33x1.80mm_HandSolder
C7, C9: 100n; C_0805_2012Metric_Pad1.18x1.45mm_HandSolder
D3: D_Schottky; DIOM4325X250N
EN: SWT0010-015016SSA_REVA; SW_SWT0010-015016SSA_REVA
H1, H2, H3: MountingHole_Pad; MountingHole_2.2mm_M2_Pad_TopBottom
J1: USB4215-03-A_REVA; GCT_USB4215-03-A_REVA
J2: Conn_01x06_Pin; PinHeader_1x06_P2.54mm_Vertical
J3, J4: Conn_01x04_Pin; PinHeader_1x04_P2.54mm_Vertical
LED: LED; LED_0805_2012Metric_Pad1.15x1.40mm_HandSolder
POWER: LED; LED_0805_2012Metric_Pad1.15x1.40mm_HandSolder
R1, R2, R7, R8, R11: 10k; R_0805_2012Metric_Pad1.20x1.40mm_HandSolder
R3, R4: 1k; R_0805_2012Metric_Pad1.20x1.40mm_HandSolder
R5, R6: 5.1k; R_0805_2012Metric_Pad1.20x1.40mm_HandSolder
R9, R10: 4.7k; R_0805_2012Metric_Pad1.20x1.40mm_HandSolder
R12, R13: 0; R_0805_2012Metric_Pad1.20x1.40mm_HandSolder
S3: SWT0010-015016SSA_REVA; SW_SWT0010-015016SSA_REVA
U1: ESP32-C3-WROOM-02U-N4; XCVR_ESP32-C3-WROOM-02U-N4
U2: BME680; Bosch_LGA-8_3x3mm_P0.8mm_ClockwisePinNumbering
U4: AMS1117-3.3; SOT-223-3_TabPin2

Connections:
+3.3V: C2.2, C3.2, C4.1, C7.1, C8.1, C9.1, J2.5, J3.1, POWER.2 (A), R1.2, R2.2, R7.2, R8.2, R9.1, R10.2, R11.2, U1.1 (3V3), U2.2 (CSB), U2.6 (VDDIO), U2.8 (VDD), U4.2 (VO)
+5V: C5.1, D3.1 (K), J4.1, U4.3 (VI)
BOOT: BOOT.2, C6.2, R2.1, U1.8 (IO9)
D+: R13.1, U1.14 (IO19)
D-: R12.2, U1.13 (IO18)
EN: C1.2, EN.2, R1.1, U1.2 (EN)
GND: BOOT.1, C1.1, C2.1, C3.1, C4.2, C5.2, C6.1, C7.2, C8.2, C9.2, C10.1, EN.1, H1.1, H2.1, H3.1, J1.A1_B12 (GND_A), J1.B1_A12 (GND_B), J1.SH1 (SHIELD), J1.SH2 (SHIELD), J1.SH3 (SHIELD), J1.SH4 (SHIELD), J2.6, J3.4, J4.4, R3.2, R4.2, R5.2, R6.2, S3.1, U1.9 (GND), U1.19_1 (GND), U1.19_2 (GND), U1.19_3 (GND), U1.19_4 (GND), U1.19_5 (GND), U1.19_6 (GND), U1.19_7 (GND), U1.19_8 (GND), U1.19_9 (GND), U1.20_1, U1.20_2, U1.20_3, U1.20_4, U1.20_5, U1.20_6, U1.20_7, U1.20_8, U1.20_9, U1.20_10, U1.20_11, U1.20_12, U2.1 (GND), U2.5 (SDO), U2.7 (GND), U4.1 (GND)
GPIO0: J2.1, U1.18 (IO0)
GPIO1: J2.2, U1.17 (IO1)
GPIO3: J4.2, U1.15 (IO3)
GPIO4: J4.3, U1.3 (IO4)
GPIO7: C10.2, R11.1, S3.2, U1.6 (IO7)
LED: LED.2 (A), U1.10 (IO10)
unnamed: D3.2 (A), J1.A4_B9 (VBUS_A), J1.B4_A9 (VBUS_B)
unnamed: J1.A5 (CC1), R6.1
unnamed: J1.B5 (CC2), R5.1
unnamed: J1.A7 (DN1), J1.B7 (DN2), R12.1
unnamed: J1.A6 (DP1), J1.B6 (DP2), R13.2
unnamed: LED.1 (K), R3.1
unnamed: POWER.1 (K), R4.1
unnamed: R8.1, U1.16 (IO2)
unnamed: R7.1, U1.7 (IO8)
RX: J3.3, U1.11 (RXD/IO20)
SCL: J2.4, R10.1, U1.5 (IO6), U2.4 (SCK)
SDA: J2.3, R9.2, U1.4 (IO5), U2.3 (SDI)
TX: J3.2, U1.12 (TXD/IO21)
