IoT-Systems-Lab/Smart-Bike/(commit log)

2025-10-12 Update PCB design
    DRC errors opgelost, teardrops toegevoegd, routing optimaliseren, kleine details
    [PCB_gateway.kicad_pcb]
2025-10-12 update silkscreen
    [PCB_gateway.kicad_pcb]
2025-10-14 Header silkscreen
    added pin description for each header on the silkscreen
    [PCB_gateway.kicad_pcb]
2025-10-19 Added voorvork schematics and PCB
    [PCB1.PcbDoc, SmartBike.PrjPcb, Voorvork.SchDoc]
2025-10-20 added main bike pcb files
    [Main_Bike_Print.csv, Main_Bike_Print.kicad_pcb, Main_Bike_Print.kicad_sch]
2025-10-20 Added bom folder
2025-10-20 added bom files
    [BOM_Mouser.xlsx, BOM_digikey.xlsx]
2025-11-12 Delete Sensors/Code/Temp
    Deleted temporary file
2025-11-13 sensors work
2025-11-13 Added sensor code for GNSS
2025-11-17 Add averaging and pass detection to sensor data loop
    Refactors the main loop to sample sensor data at regular intervals, accumulate values for averaging, and publish averaged results periodically. Adds pass detection using the ultrasonic sensor, records pass times, and includes them in the published data. Updates pin configuration, initializes new pins, and improves time formatting for pass events.
2025-11-17 Adjust IAQ calculation scaling factor in sampleIfDue function
2025-11-18 Delete Sensors/Voorvork/Temp
    Deletion of temporary file
2025-11-28 BLE sensoren
2025-12-01 Arduino test files for backup solution
2025-12-12 Add files via upload
    Werkende code voor opmeten en versturen van onze sensoren.
2025-12-18 Finale versie van de code van team sensors
